skyhawk180/DIP-HDMI-PCB/README.md

# Source Files
C.H.I.P. HDMI Display DIP is designed using Eagle!

# DIP-HDMI-PCB

HDMI DIP = v1.0

#License
<br />This work is licensed under a <a rel="license" href="http://creativecommons.org/licenses/by-sa/3.0/us/">Creative Commons Attribution-ShareAlike 3.0 United States License</a>.
