skyhawk180/DIP-HDMI-PCB/v1.0/Datasheets/CH7053A_88QFN_Pac;kage_Top_View.png

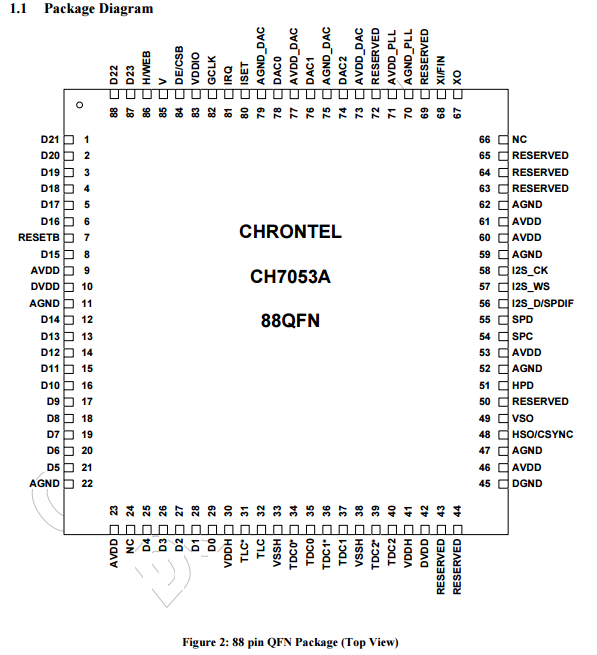
v1.0/Datasheets/CH7053A_88QFN_Pac;kage_Top_View.png
