skyhawk180/DIP-HDMI-PCB/(list of files, cad)

Other CAD files:
v1.0/DXF/DIP-HDMI-v1.0_topSilk.dwg
