skyhawk180/DIP-HDMI-PCB/(commit log)

2016-06-02 updated readme, added PDFs
    [DIP-HDMI-v1.0_topSilk.dwg]
2016-06-02 added datasheets and layer stack up
    [DIP-HDMI-v1.0.sch]
